xoseperez/wordclock/code/wordclock/src/catalan.h

/*

  Word Clock
  Copyright (C) 2015 by Xose Pérez <xose dot perez at gmail dot com>

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
*/

#define CAT_ES          {0, 0xC000}
#define CAT_SON         {0, 0x7000}
#define CAT_VORA        {0, 0x00F0}

#define CAT_UN_Q        {1, 0xC000}
#define CAT_DOS_Q       {1, 0x3800}
#define CAT_TRES_Q      {1, 0x0780}
#define CAT_MIG         {1, 0x0007}

#define CAT_QUART       {2, 0xF800}
#define CAT_QUARTS      {2, 0xFC00}
#define CAT_I           {2, 0x0100}
#define CAT_I_MIG       {2, 0x0107}
#define CAT_MENYS       {2, 0x00F8}

#define CAT_CINC_Q      {3, 0xF000}
#define CAT_BEN_Q       {3, 0x0700}
#define CAT_TOCAT       {3, 0x003E}
#define CAT_TOCATS      {3, 0x003F}

#define CAT_LES         {4, 0xE000}
#define CAT_DE          {4, 0x1800}
#define CAT_LA          {4, 0x0600}
#define CAT_DUES        {4, 0x00F0}
#define CAT_SIS         {4, 0x001C}
#define CAT_SET         {4, 0x0007}

#define CAT_CINC        {5, 0xF000}
#define CAT_VUIT        {5, 0x00F0}
#define CAT_UNA         {5, 0x0007}
#define CAT_D_UNA       {5, 0x000F}

#define CAT_DOS         {6, 0xE000}

#define CAT_QUATRE      {7, 0xFC00}
#define CAT_TRES        {7, 0x1E00}

#define CAT_ONZE        {9, 0x7800}
#define CAT_D_ONZE      {9, 0xF800}
#define CAT_DOTZE       {9, 0x07C0}
#define CAT_NOU         {9, 0x0038}
#define CAT_DEU         {9, 0x0007}

#define CAT_BEN         {12, 0xE000}
#define CAT_TOCADES     {12, 0x0FE0}
#define CAT_EN_PUNT     {12, 0x601E}

#define CAT_TOCADA      {13, 0xFC00}

#define CAT_DE_F        {14, 0xC000}
#define CAT_DEL         {14, 0xE000}
#define CAT_LA_F        {14, 0x1800}
#define CAT_MATI        {14, 0x0780}
#define CAT_NIT         {14, 0x0070}
#define CAT_TARDA       {14, 0x001F}

void loadCode(clockword code, unsigned int * matrix);
void loadLanguageCatalan(byte hour, byte minute, unsigned int * matrix);
