xoseperez/wordclock/(commit log)

2015-05-21 SCAD models
    [wordclock-16x16-5mm-20150519.stl, wordclock-acrilic-nieve-3mm.dxf, wordclock-acrilic-transparente-3mm.dxf, wordclock.scad]
2015-06-11 Text mask in CA and ES
    [wordclock.scad]
2015-11-02 Updated models, fix typos and some changes in characters
    [wordclock-acrilic-transparente-3mm.dxf, wordclock.scad]
2015-11-09 Reset seconds after changing time to sync clock
    [wordclock.ino]
2015-11-25 Fix bug in word definition
    [catalan.cpp, catalan.h]
2015-12-16 Changed RTC lib to Adafruit's fork of JeeLab's library for Arduino and fixed small typo in character template
    [catalan.h, wordclock.ino]
2017-04-20 Added 8x8 matrix dispplays to SCAD
    [wordclock-acrilic-nieve-3mm.dxf, wordclock.scad]
2021-05-07 Latest updates
    [wordclock-16x16-5mm-20150519.stl, wordclock.scad]
